ColorlessSapphire/CSPS_ATX12VO/1. Hardware/ATX12VO 10Pin主板接口.jpg

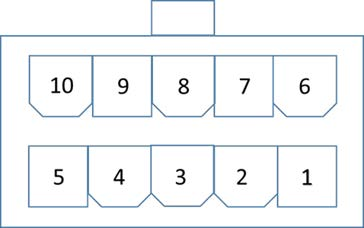
1. Hardware/ATX12VO 10Pin主板接口.jpg
