ColorlessSapphire/CSPS_ATX12VO/1. Hardware/ATX12VO 10Pin主板接口外形.jpg

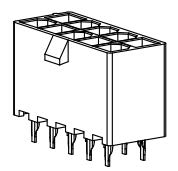
1. Hardware/ATX12VO 10Pin主板接口外形.jpg
