ColorlessSapphire/CSPS_ATX12VO/1. Hardware/ATX12VO 10Pin主板接口引脚定义.png

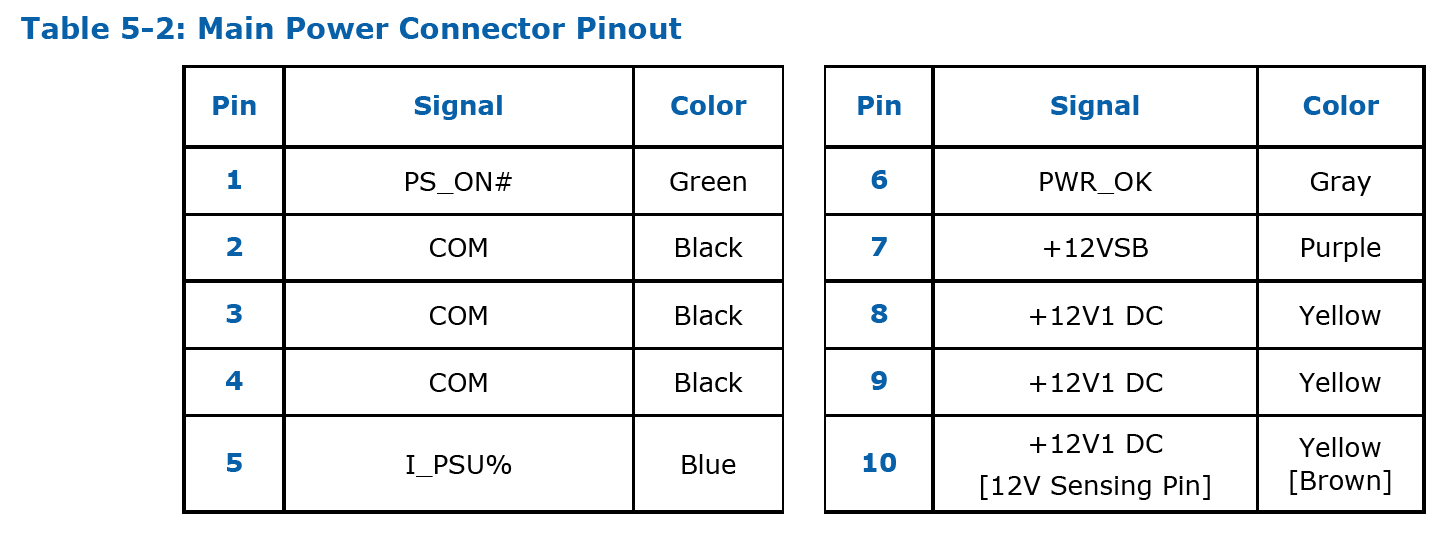
1. Hardware/ATX12VO 10Pin主板接口引脚定义.png
