ColorlessSapphire/CSPS_ATX12VO/1. Hardware/ATX标准线序.jpg

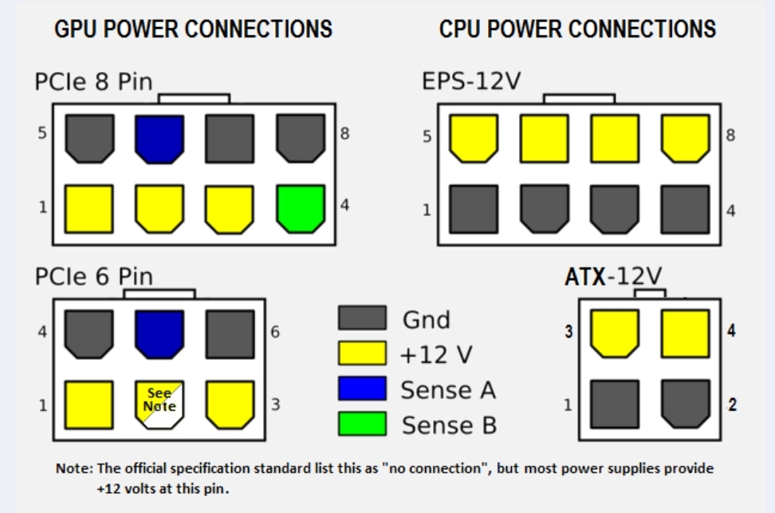
1. Hardware/ATX标准线序.jpg
