ColorlessSapphire/CSPS_ATX12VO/1. Hardware/PCB-CSPS-ATX12VO-NAK12S20_2.png

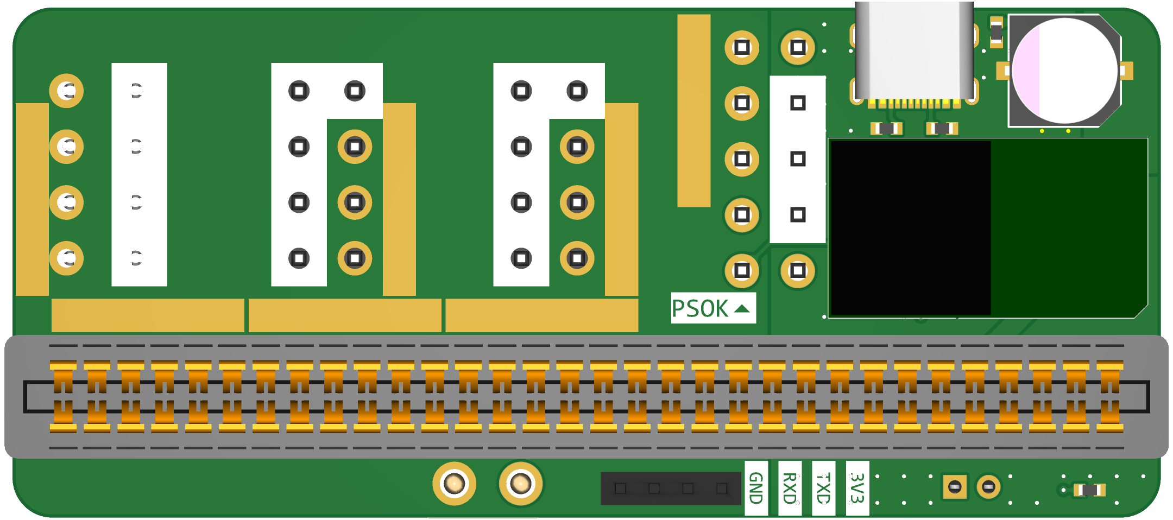
1. Hardware/PCB-CSPS-ATX12VO-NAK12S20_2.png
