ColorlessSapphire/CSPS_ATX12VO/1. Hardware/PCB-DCATX-ATX24Pin_1.png

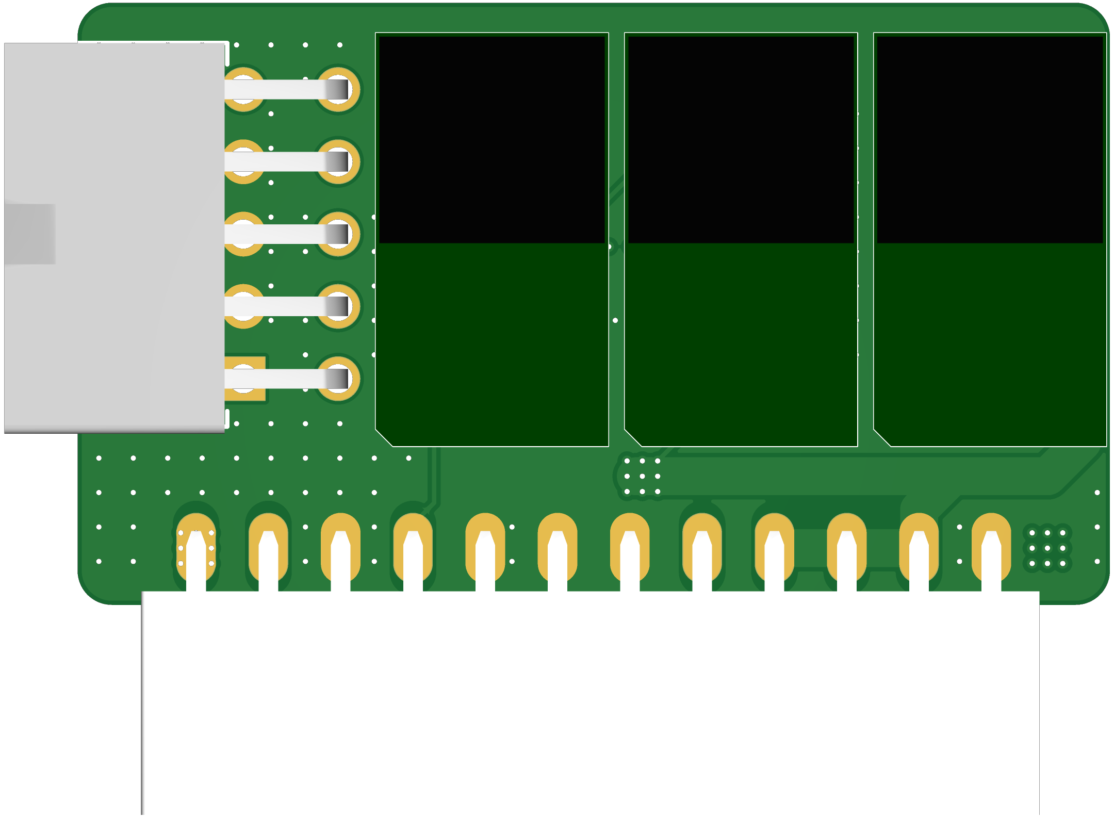
1. Hardware/PCB-DCATX-ATX24Pin_1.png
