ColorlessSapphire/CSPS_ATX12VO/1. Hardware/PCB-DCATX-ATX24Pin_2.png

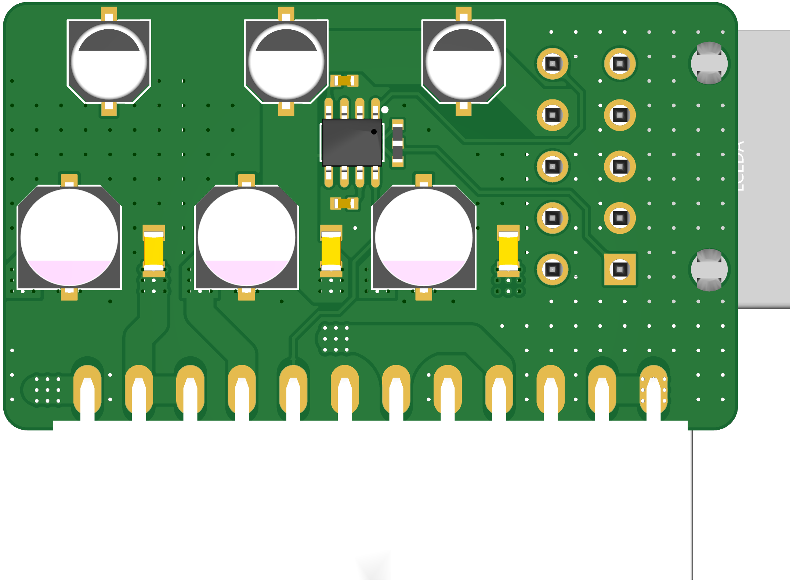
1. Hardware/PCB-DCATX-ATX24Pin_2.png
