ColorlessSapphire/CSPS_ATX12VO/1. Hardware/引脚定义.png

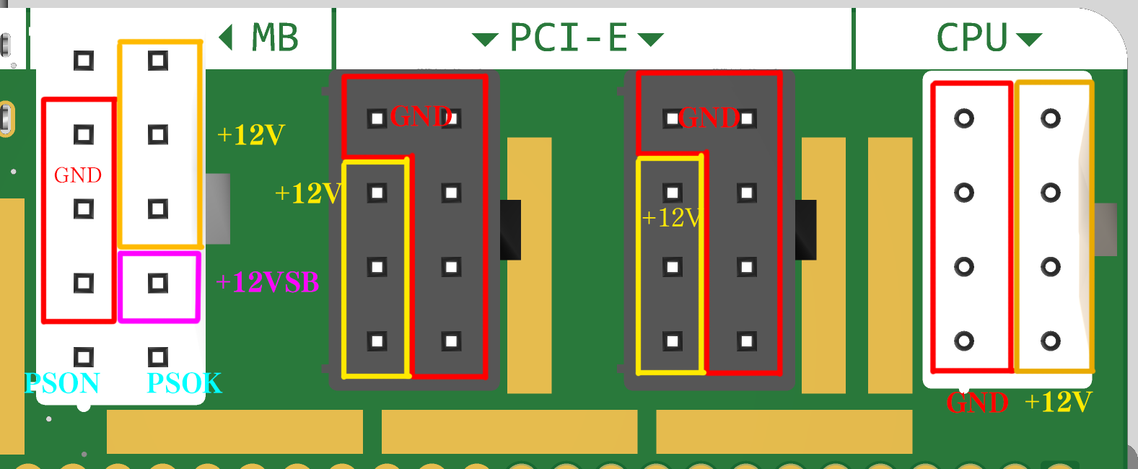
1. Hardware/引脚定义.png
