ColorlessSapphire/CSPS_ATX12VO/(list of files, drawings)

Other design files:
1. Hardware/ProDocument_CSPS-ATX12VO-NAK12S20_2023-09-14.epro
1. Hardware/ProDocument_DCATX-ATX24Pin_2023-09-14.epro
